anan112pcmec/Kavling-Pintar-Prep-PKMC2027/foto/pakcoy.jpg

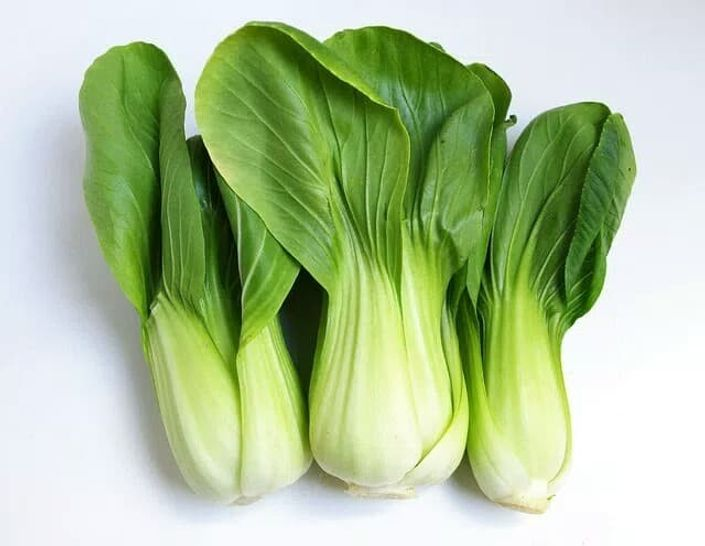
foto/pakcoy.jpg
