anan112pcmec/Kavling-Pintar-Prep-PKMC2027/foto/kailan.jpg

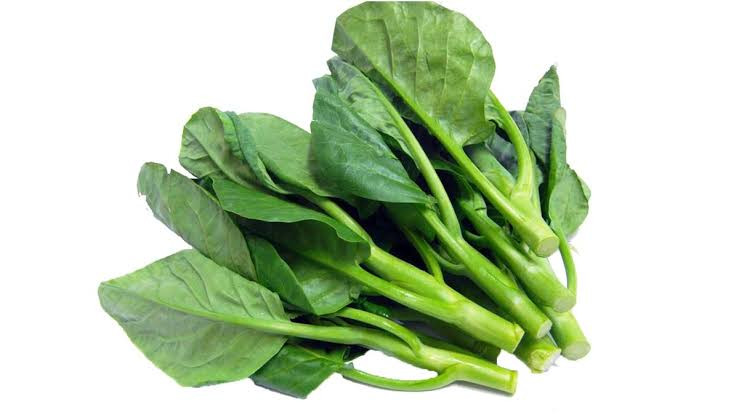
foto/kailan.jpg
