anan112pcmec/Kavling-Pintar-Prep-PKMC2027/foto/Penampang_Dimensi.png

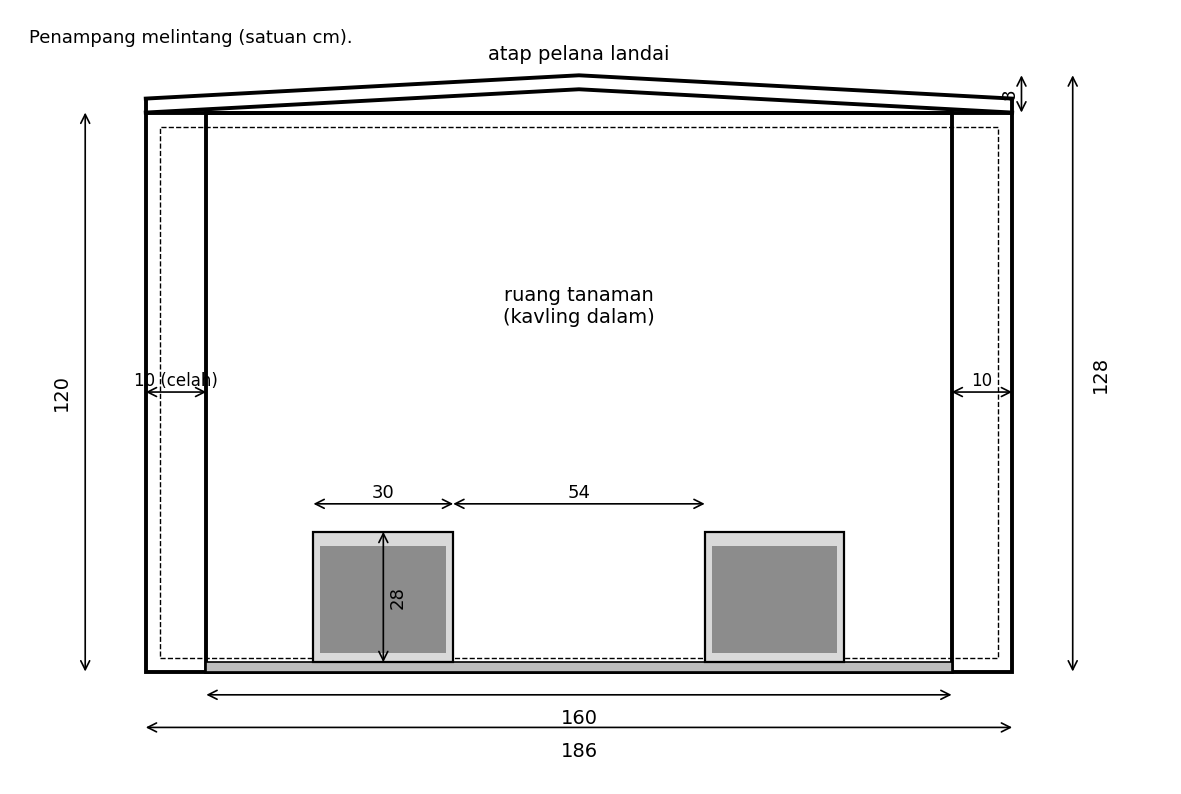
foto/Penampang_Dimensi.png
