anan112pcmec/Kavling-Pintar-Prep-PKMC2027/foto/Potongan_Samping_Kipas.png

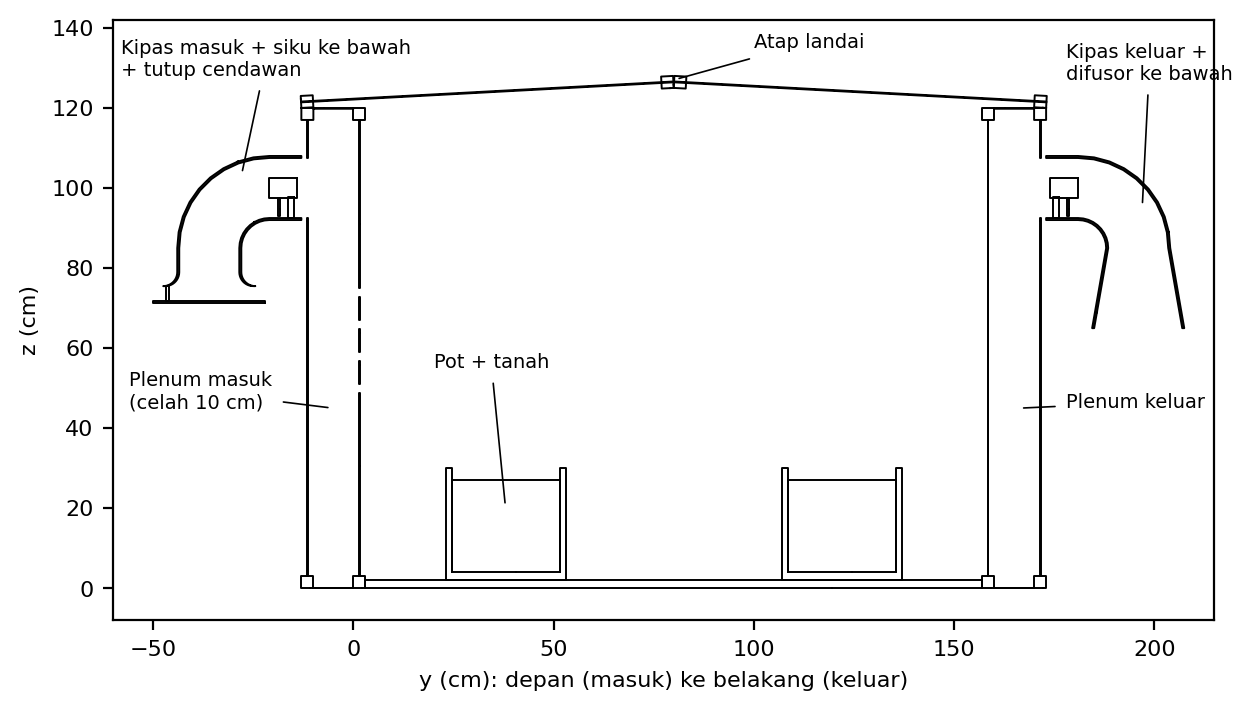
foto/Potongan_Samping_Kipas.png
