anan112pcmec/Kavling-Pintar-Prep-PKMC2027/foto/sawi.jpeg

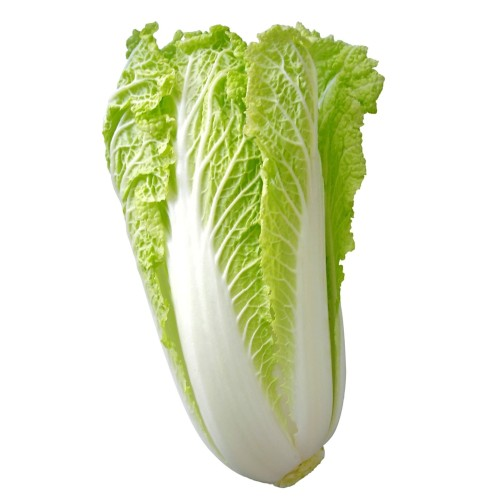
foto/sawi.jpeg
