anan112pcmec/Kavling-Pintar-Prep-PKMC2027/kavling_supply_box_v2_rakit.stl

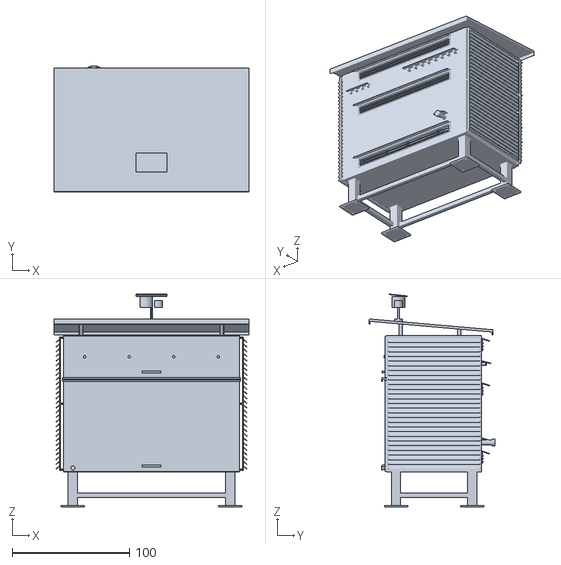
[picture p21: CAD file, 2026-10-17]
kavling_supply_box_v2_rakit.stl
166.0 x 107.7 x 181.6
