anan112pcmec/Kavling-Pintar-Prep-PKMC2027/kavling_interface_box_rakit.stl

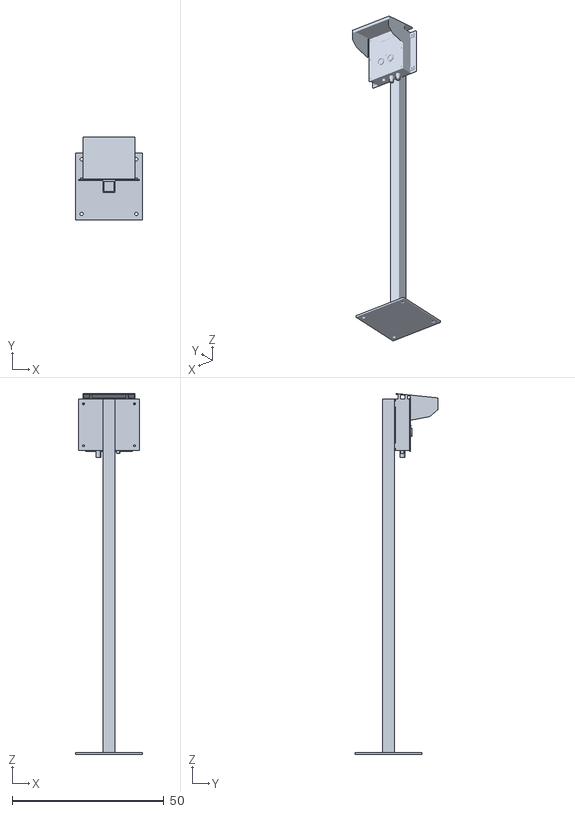
[picture p22: CAD file, 2026-10-17]
kavling_interface_box_rakit.stl
22.0 x 27.3 x 118.8
