anan112pcmec/Kavling-Pintar-Prep-PKMC2027/Kavling_Pintar_Combined.stl

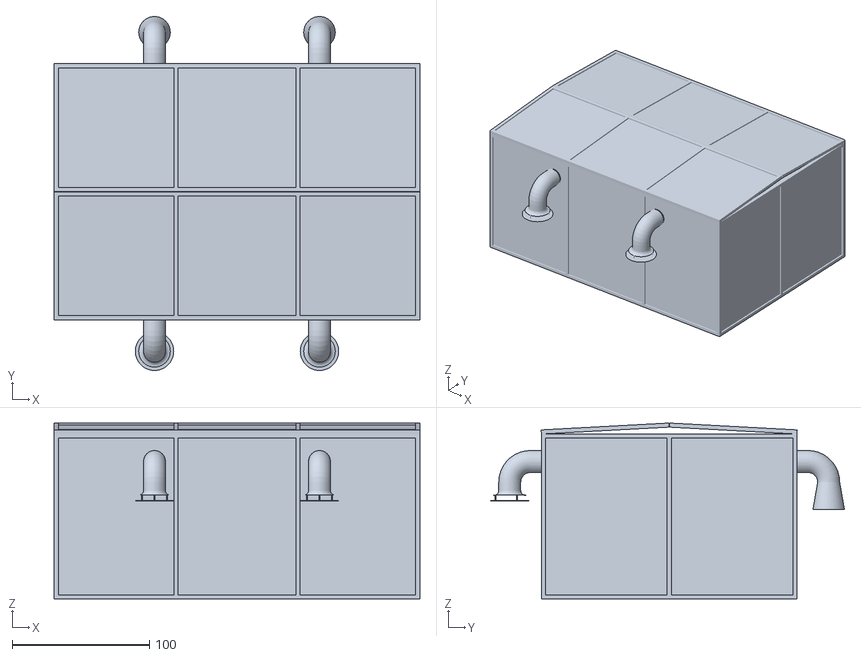
[picture p23: CAD file, 2026-10-15]
Kavling_Pintar_Combined.stl
266.0 x 257.5 x 128.0
