anan112pcmec/Kavling-Pintar-Prep-PKMC2027/Kavling_Pintar_Rangka_Combined.stl

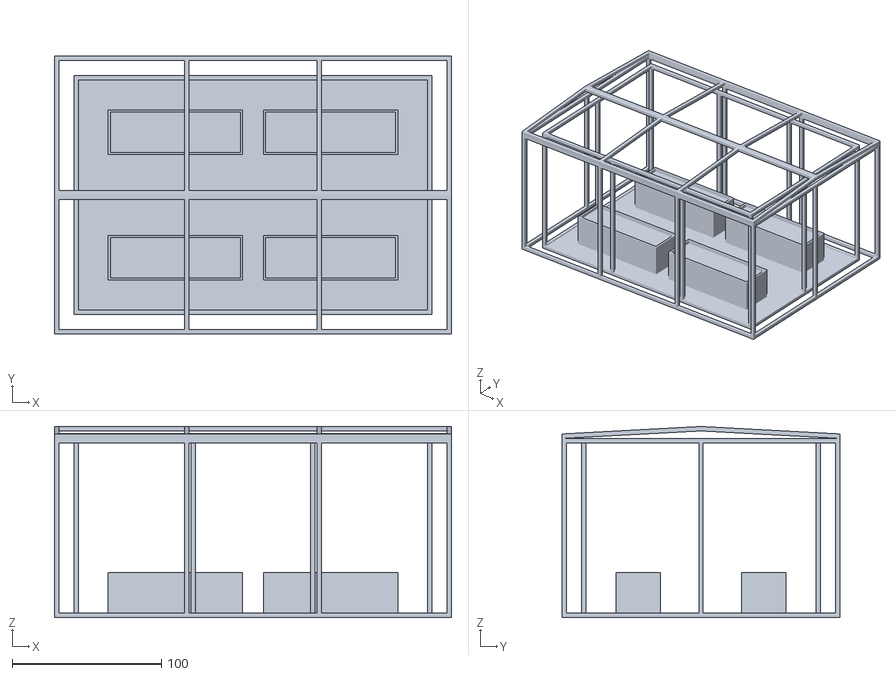
[picture p24: CAD file, 2026-10-15]
Kavling_Pintar_Rangka_Combined.stl
266.0 x 186.3 x 128.0
