anan112pcmec/Kavling-Pintar-Prep-PKMC2027/kavling_komponen_dijejer.stl

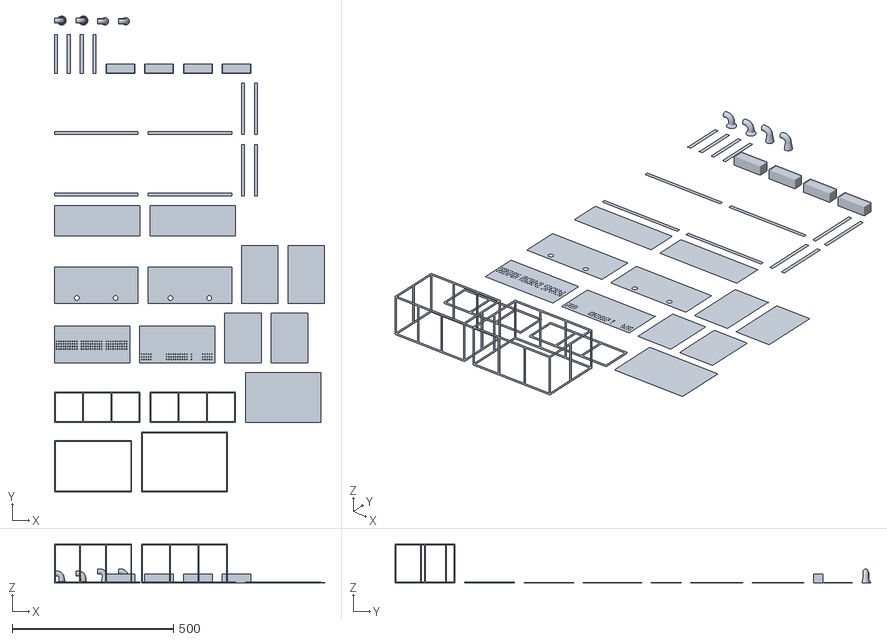
[picture p25: CAD file, 2026-10-15]
kavling_komponen_dijejer.stl
838.0 x 1475.1 x 120.0
