anan112pcmec/Kavling-Pintar-Prep-PKMC2027/(commit log)

2026-10-15 insert core files
    [Kavling_Pintar_Combined.stl, Kavling_Pintar_Rangka_Combined.stl, kavling_komponen_dijejer.stl]
2026-10-17 update bagian sistem rincian format
    [kavling_interface_box_rakit.stl, kavling_supply_box_v2_rakit.stl]
